grodansparadis/vscp-din-wireless-esp32-flat/README.md

# vscp-din-wireless-esp32-flat
ESP32 based VSCP controller in flat DIN package

**Note!** This is still a prototype.

## PCB's
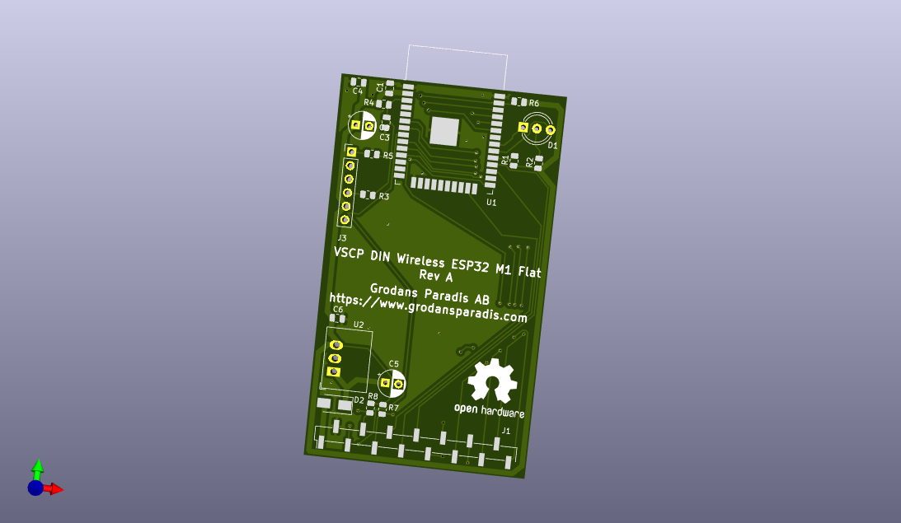
[picture p1: images/vscp-din-wireless-esp32-flat-top.png]
Control Interface Top


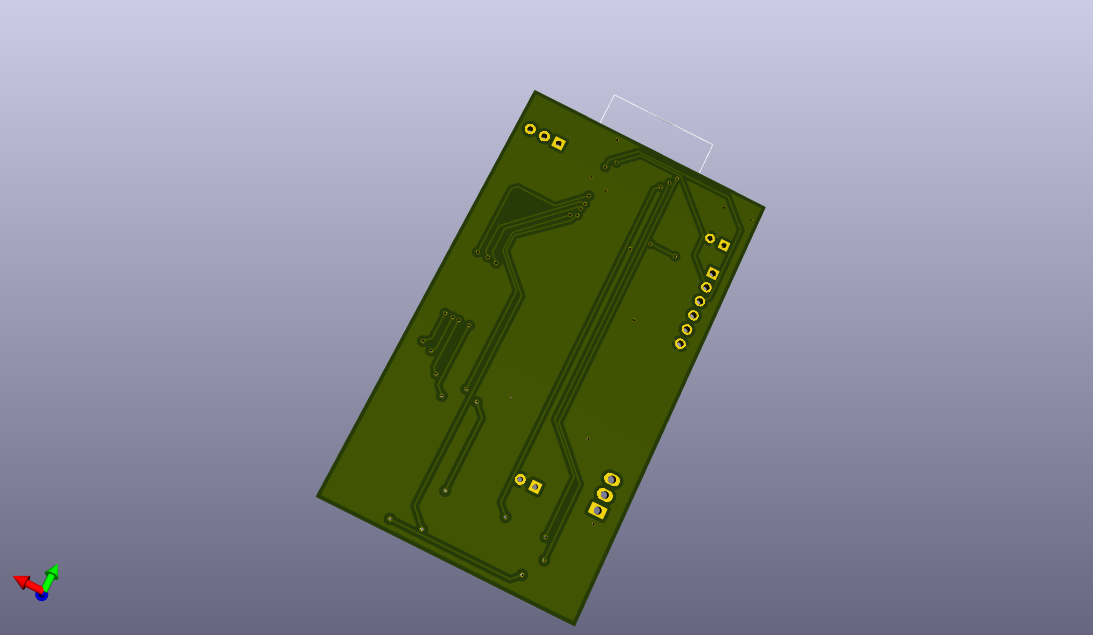
[picture p2: images/vscp-din-wireless-esp32-flat-top-bottom.png]
Control Interface Bottom
 

---

Part of the [VSCP Project](https://www.vscp.org).

Copyright 2021-2025 © Åke Hedman, (Grodans Paradis AB)[https://www.grodansparadis.com]
