grodansparadis/vscp-din-wireless-esp32-flat/(commit log)

2021-05-24 Initial import
    [vscp-din-wireless-esp32-flat.kicad_pcb, vscp-din-wireless-esp32-flat.sch]
2021-05-24 pcb cad in place
    [vscp-din-wireless-esp32-flat.kicad_pcb, vscp-din-wireless-esp32-flat.sch]
2021-05-25 Adding gerbers
    [vscp-din-wireless-esp32-flat-B_Cu.gbr, vscp-din-wireless-esp32-flat-B_Mask.gbr, vscp-din-wireless-esp32-flat-B_Paste.gbr, vscp-din-wireless-esp32-flat-B_SilkS.gbr, vscp-din-wireless-esp32-flat-Edge_Cuts.gbr, vscp-din-wireless-esp32-flat-F_Cu.gbr, vscp-din-wireless-esp32-flat-F_Mask.gbr, vscp-din-wireless-esp32-flat-F_Paste.gbr]
2021-08-09 Fitted border components to enclosure
    [vscp-din-wireless-esp32-flat.kicad_pcb]
2021-08-09 Changed termination block to true hole version
    [vscp-din-wireless-esp32-flat.kicad_pcb, vscp-din-wireless-esp32-flat.sch]
2025-09-17 Updated to KiCad 9
    [vscp-din-wireless-esp32-flat.kicad_pcb, vscp-din-wireless-esp32-flat.kicad_sch]
2025-09-17 Changed power input diod to SS34
    [vscp-din-wireless-esp32-flat.kicad_sch]
