grodansparadis/vscp-din-wireless-esp32-flat/(notices)

Notices in the files:
vscp-din-wireless-esp32-flat.sch:
Copyright © Åke Hedman, Grodans Paradis AB
